bwestcott-ece/SPO2/AMP.png

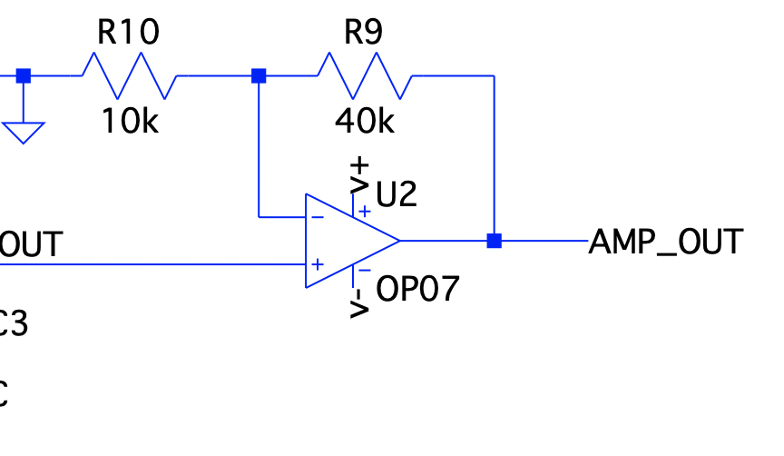
AMP.png
