bwestcott-ece/SPO2/BP.png

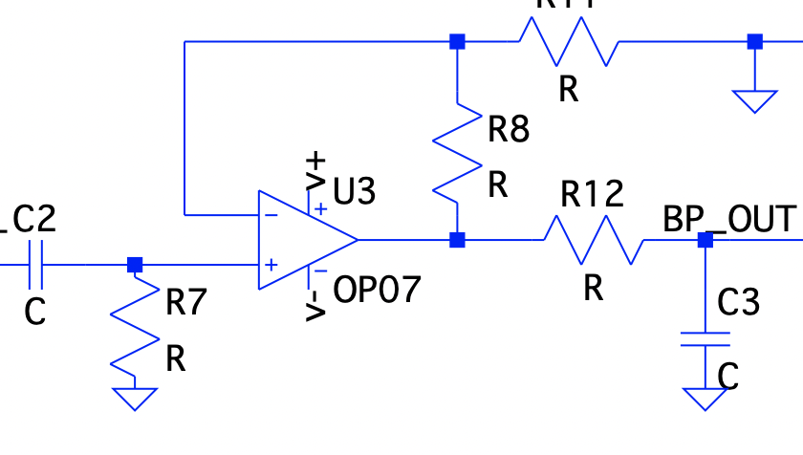
BP.png
