bwestcott-ece/SPO2/pics/HEART_BEAT.JPG

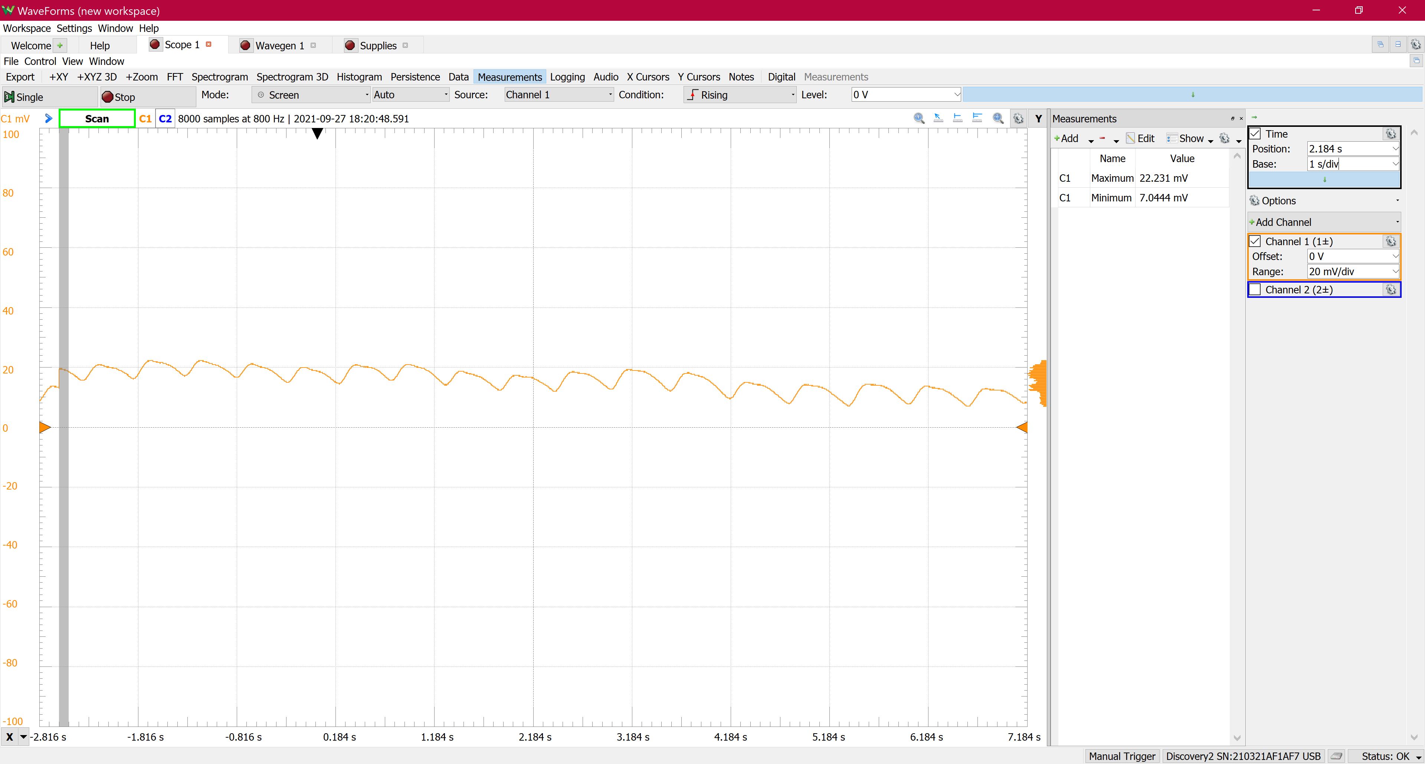
pics/HEART_BEAT.JPG
