bwestcott-ece/SPO2/pics/no_finger.JPG

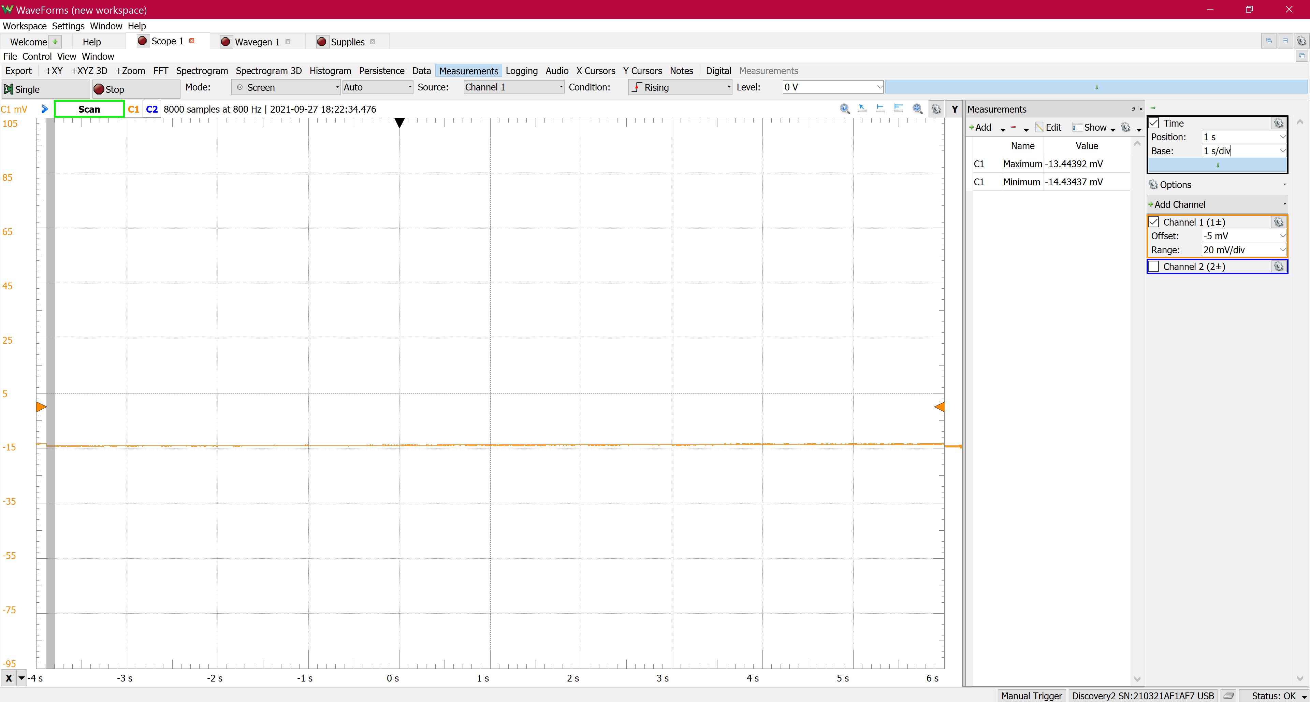
pics/no_finger.JPG
