bwestcott-ece/SPO2/Screen Shot 2021-09-30 at 7.47.02 PM.png

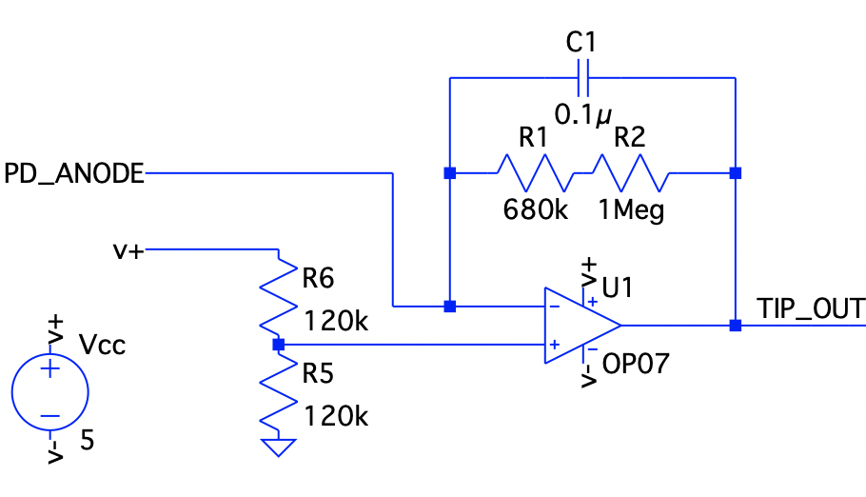
Screen Shot 2021-09-30 at 7.47.02 PM.png
