bwestcott-ece/SPO2/Screen Shot 2021-09-30 at 8.07.01 PM.png

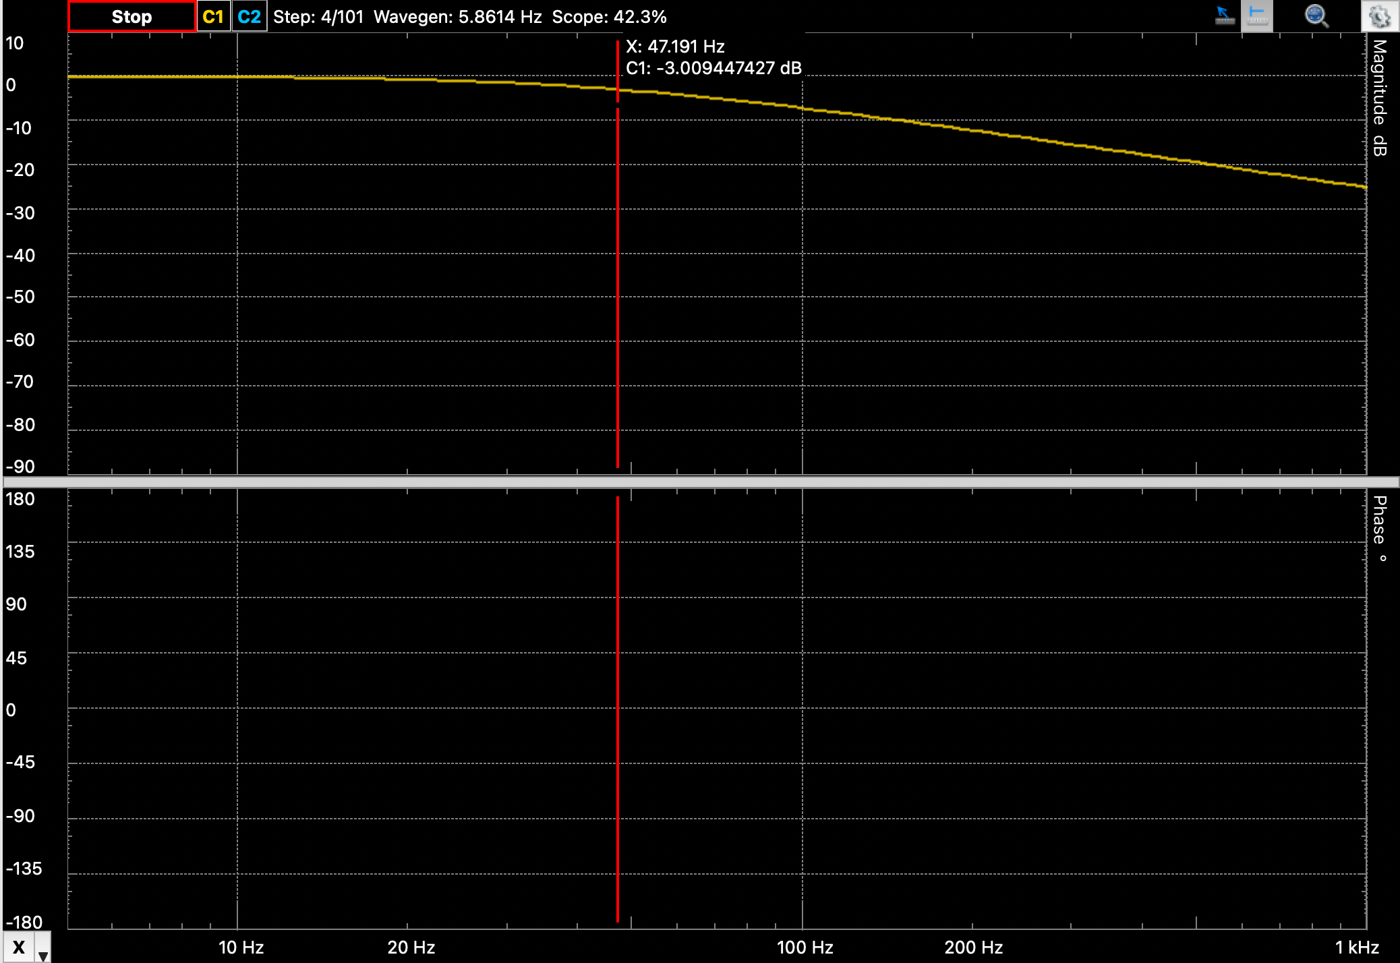
Screen Shot 2021-09-30 at 8.07.01 PM.png
