bwestcott-ece/SPO2/SensorIO.png

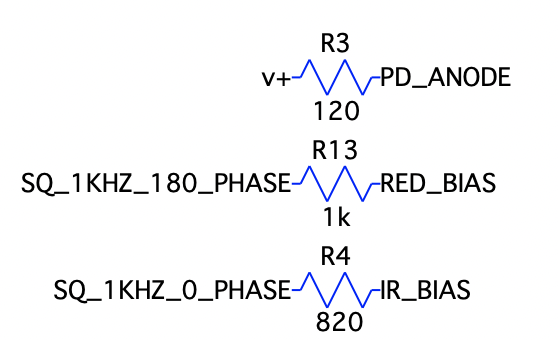
SensorIO.png
